ABangingDonk/OpenHaldexDue/media/v0.1_board.jpg

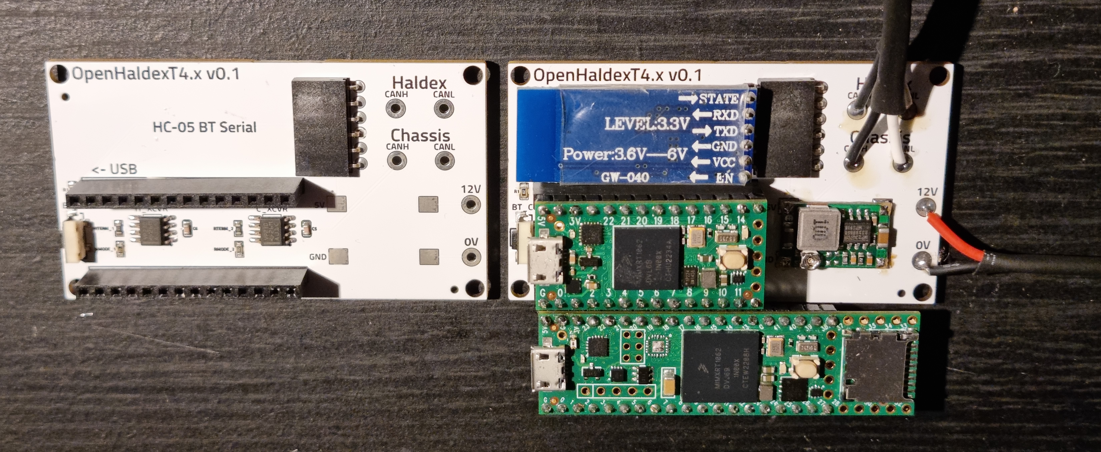
media/v0.1_board.jpg
