ABangingDonk/OpenHaldexDue/Interceptor/openhaldex_interceptor/openhaldex_interceptor.ino

/*
 * MIT License
 * 
 * Copyright (c) 2018 ABangingDonk
 * 
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
 * OpenHaldex interceptor:
 *  Forwards all CAN frames (except those from the master) to the haldex
 *  Master frames are read into persistent_config.mode and false_slip globals
 *
 * Some experimentation to be done with regards to false_slip and BRAKES1
 * frames... I've seen a maximum haldex engagement of 0xc6, I'm sure there's
 * more to be had here.
 *
 * At the very least, we can keep the haldex enaged through braking by editing
 * the brake pedal signal sent in BRAKES1.
 */

#include "variant.h"
#include <due_can.h>
#include <Timer.h>
#include "DueFlashStorage.h"
#include <stdio.h>

#define ARRAY_LEN(array)    ((size_t)(sizeof(array) / sizeof(array[0])))

//Leave defined if you use native port, comment if using programming port
//#define Serial SerialUSB

#define HALDEX_ID                 0x2C0
#define BRAKES1_ID                0x1A0
#define BRAKES3_ID                0x4A0
#define MOTOR1_ID                 0x280
#define MOTOR2_ID                 0x288
#define MOTOR3_ID                 0x380
#define MOTOR6_ID                 0x488
#define INTERCEPTOR_INFO_ID       0x7fb
#define INTERCEPTOR_DATA_CTRL_ID  0x7fc
#define MASTER_MODE_ID            0x7fd
#define MASTER_DATA_CTRL_ID       0x7fe
#define MASTER_DATA_ID            0x7ff

#define MODE_STOCK   0x0
#define MODE_FWD     0x1
#define MODE_5050    0x2
#define MODE_CUSTOM  0x3

#define DATA_CTRL_CHECK_LOCKPOINTS  0
#define DATA_CTRL_CLEAR             1
#define DATA_CTRL_CHECK_MODE        2

#define CAN0_DEBUG      0
#define CAN1_DEBUG      0
#define STATE_DEBUG     0

#define NUM_LOCK_POINTS 10

typedef struct lockpoint{
    uint8_t speed;
    uint8_t lock;
    uint8_t intensity;
}lockpoint;

typedef struct PersistentConfig{
    uint8_t mode;
    float ped_threshold;
    lockpoint lockpoints[NUM_LOCK_POINTS];
}PersistentConfig;

static PersistentConfig persistent_config;
DueFlashStorage dueFlashStorage;
static uint16_t lockpoint_rx = 0;
static uint8_t lockpoint_count = 0;
Timer t;
static uint8_t vehicle_speed = 0;
static float lock_target = 0;
static float ped_value = 0;

#if STATE_DEBUG
static char s[128];
#endif

static float get_lock_target_adjustment(void)
{
    float target = 0;
    
    /* Find out which lockpoints we're between in terms of speed..
     * Look for the lockpoint above our current speed (lp_upper) */
    lockpoint lp_lower = persistent_config.lockpoints[0];
    lockpoint lp_upper = persistent_config.lockpoints[lockpoint_count - 1];

    for (int i = 0; i < lockpoint_count; i++)
    {
        if (vehicle_speed <= persistent_config.lockpoints[i].speed)
        {
            lp_upper = persistent_config.lockpoints[i];
            lp_lower = persistent_config.lockpoints[(i == 0) ? 0 : i - 1];
            break;
        }
    }
    
    /* Get the easy cases out the way first... */
    if (vehicle_speed <= lp_lower.speed)
    {
        return lp_lower.lock;
    }
    if (vehicle_speed >= lp_upper.speed)
    {
        return lp_upper.lock;
    }
        
    /* If locking at all... */
    if (ped_value > persistent_config.ped_threshold || persistent_config.ped_threshold == 0)
    {
        /* Need to interpolate */
        float inter = (float)(lp_upper.speed - lp_lower.speed) / (float)(vehicle_speed - lp_lower.speed);

        target = lp_lower.lock + ((float)(lp_upper.lock - lp_lower.lock) / inter);
        #if STATE_DEBUG
        sprintf(s, "lp_upper:%d@%d lp_lower:%d@%d speed:%d target=%0.2f", 
                lp_upper.lock, lp_upper.speed, lp_lower.lock, lp_lower.speed, vehicle_speed, target);
        Serial.println(s);
        #endif
    }
    /* Else leave target at its initial value of 0. */

    return target;
}

static uint8_t get_lock_target_adjusted_value(uint8_t value)
{    
    if (persistent_config.mode == MODE_5050)
    {
        if (ped_value > persistent_config.ped_threshold || persistent_config.ped_threshold == 0)
        {
            return value;
        }
        
        return 0;
    }
    else
    {
        float target = get_lock_target_adjustment();
        lock_target = target;
        
        /*
         * Hackery to get the response closer to the target... we are trying to control the
         * Haldex as if it's linear.. but it's not. In future, I'd like to implement some sort
         * of feedback loop to trim the calculation being made here but this will do for now.
         */
        target = (target / 2) + 20;
        
        return value * (target / 100);
    }
}

static void get_lock_data(CAN_FRAME *frame)
{   
    uint8_t adjusted_slip;
    switch(frame->id)
    {
        case MOTOR1_ID:
            frame->data.bytes[0] = 0;
            frame->data.bytes[1] = get_lock_target_adjusted_value(0xf0);
            frame->data.bytes[2] = 0x20;
            frame->data.bytes[3] = get_lock_target_adjusted_value(0x4e);
            frame->data.bytes[4] = get_lock_target_adjusted_value(0xf0);
            frame->data.bytes[5] = get_lock_target_adjusted_value(0xf0);
            frame->data.bytes[6] = 0x20;
            frame->data.bytes[7] = get_lock_target_adjusted_value(0xf0);
            break;
        case MOTOR3_ID:
            frame->data.bytes[2] = get_lock_target_adjusted_value(0xfa);
            frame->data.bytes[7] = get_lock_target_adjusted_value(0xfe);
            break;
        case MOTOR6_ID:
            frame->data.bytes[1] = get_lock_target_adjusted_value(0xfe);
            frame->data.bytes[2] = get_lock_target_adjusted_value(0xfe);
            break;
        case BRAKES3_ID:
            adjusted_slip = get_lock_target_adjusted_value(0xff);
            frame->data.high = (0xa << 24) + (0xa << 8);
            frame->data.low = frame->data.high + (adjusted_slip << 16) + adjusted_slip;
            break;
        case BRAKES1_ID:
            //frame->data.bytes[1] &= ~0x8;
            frame->data.bytes[2] = 0x0;
            frame->data.bytes[3] = 0xa;
            break;
    }
}

void update_eeprom(void* context)
{
    byte *old_data = dueFlashStorage.readAddress(4);
    // If config has changed then we should update it
    if (memcmp(old_data, &persistent_config, sizeof(persistent_config)))
    {
        byte new_data[sizeof(persistent_config)];
        memcpy(new_data, &persistent_config, sizeof(persistent_config));
        dueFlashStorage.write(4, new_data, sizeof(new_data));
    }
}

void haldex_callback(CAN_FRAME *incoming)
{
    Can1.sendFrame(*incoming, 7);

    #if CAN0_DEBUG
    if(incoming->data.bytes[0])
    {
        Serial.print("ID: 0x");
        Serial.print(incoming->id,HEX);
        Serial.print(" DATA: ");
        for(int i = 0; i < incoming->length; i++)
        {
            Serial.print(incoming->data.bytes[i],HEX);
            Serial.print(" ");
        }
        Serial.println();
    }
    #endif
}

static void send_interceptor_info(void)
{
    CAN_FRAME rsp;
    rsp.id = INTERCEPTOR_INFO_ID;
    rsp.extended = false;
    rsp.data.bytes[0] = lock_target;
    rsp.data.bytes[1] = vehicle_speed;
    rsp.length = 2;
    Can1.sendFrame(rsp, 7);
}

void can1_rx_callback(CAN_FRAME *incoming)
{
    uint32_t id = incoming->id;
    
    if(id == MASTER_MODE_ID)
    {
        // We'll get this periodically from the master to tell us which mode we should be in.
        persistent_config.mode = incoming->data.bytes[0];
        persistent_config.ped_threshold = incoming->data.bytes[1];

        if (incoming->data.bytes[0] == MODE_5050)
        {
            if (ped_value > persistent_config.ped_threshold || persistent_config.ped_threshold == 0)
            {
                lock_target = 100;
            }
            else
            {
                lock_target = 0;
            }
        }
        else if (incoming->data.bytes[0] == MODE_FWD)
        {
            lock_target = 0;
        }
        
        send_interceptor_info();
    }
    else if (id == MASTER_DATA_ID)
    {
        // Receiving data for custom lock mode
        uint8_t lockpoint_index = incoming->data.bytes[0];
        
        // Make sure that the index we were given is within range
        if (lockpoint_index < NUM_LOCK_POINTS)
        {
            // Read lockpoint properties out of the CAN packet
            persistent_config.lockpoints[lockpoint_index].speed = incoming->data.bytes[1];
            persistent_config.lockpoints[lockpoint_index].lock = incoming->data.bytes[2];
            persistent_config.lockpoints[lockpoint_index].intensity = incoming->data.bytes[3];
            
            // Set the bit for this lockpoint to indicate we've received it
            lockpoint_rx |= (1 << lockpoint_index);
            
            // Stash the number of lockpoints to avoid having to calculate it later
            lockpoint_count++;
        }
    }
    else if (id == MASTER_DATA_CTRL_ID)
    {
        // Transfer control for custom lock mode data
        CAN_FRAME rsp;
        rsp.id = INTERCEPTOR_DATA_CTRL_ID;
        rsp.extended = false;
        switch (incoming->data.bytes[0])
        {
            case DATA_CTRL_CHECK_LOCKPOINTS:
            {
                // Send the bitfield value to say which lockpoints we've received
                rsp.data.bytes[0] = DATA_CTRL_CHECK_LOCKPOINTS;
                rsp.data.bytes[1] = lockpoint_rx & 0xff;
                rsp.data.bytes[2] = (lockpoint_rx << 8) & 0xff;
                rsp.length = 3;
                Can1.sendFrame(rsp, 7);
                #if CAN1_DEBUG
                    if(1)//incoming->id == MOTOR1_ID)
                    {
                        Serial.print("TX: ID: 0x");
                        Serial.print(rsp.id,HEX);
                        Serial.print(" DATA[");
                        Serial.print(rsp.length);
                        Serial.print("] : ");
                        for(int i = 0; i < rsp.length; i++)
                        {
                            Serial.print(rsp.data.bytes[i],HEX);
                            Serial.print(" ");
                        }
                        Serial.println();
                    }
                #endif
                break;
            }
            case DATA_CTRL_CLEAR:
            {
                // We've been told to clear - so clear the lockpoints and bitfield
                lockpoint_rx = 0;
                lockpoint_count = 0;
                memset(persistent_config.lockpoints, 0, sizeof(persistent_config.lockpoints));
                break;
            }
            case DATA_CTRL_CHECK_MODE:
            {
                // Send the bitfield value to say which lockpoints we've received
                rsp.data.bytes[0] = DATA_CTRL_CHECK_MODE;
                rsp.data.bytes[1] = persistent_config.mode;
                rsp.data.bytes[2] = persistent_config.ped_threshold;
                
                rsp.length = 3;
                Can1.sendFrame(rsp, 7);
                #if CAN1_DEBUG
                    if(1)//incoming->id == MOTOR1_ID)
                    {
                        Serial.print("TX: ID: 0x");
                        Serial.print(rsp.id,HEX);
                        Serial.print(" DATA[");
                        Serial.print(rsp.length);
                        Serial.print("] : ");
                        for(int i = 0; i < rsp.length; i++)
                        {
                            Serial.print(rsp.data.bytes[i],HEX);
                            Serial.print(" ");
                        }
                        Serial.println();
                    }
                #endif
                break;
            }
            default:
            {
                // Error handling?
                break;
            }
        }
    }
    else
    {
        // Anything which has come from the car.. i.e. everything except Haldex and Master.
        switch(incoming->id)
        {
            case MOTOR1_ID:
                ped_value = incoming->data.bytes[5] * 0.4;
                
                if (persistent_config.mode == MODE_FWD)
                {
                    memset(&incoming->data, 0, incoming->length);
                }
                break;
            case MOTOR2_ID:
                vehicle_speed = (uint8_t)((incoming->data.bytes[3] * 100 * 128) / 10000);
                break;
        }

        if(persistent_config.mode == MODE_5050 || persistent_config.mode == MODE_CUSTOM)
        {
            get_lock_data(incoming);
        }

        Can0.sendFrame(*incoming);
    }
#if CAN1_DEBUG
    if(1)//incoming->id == MOTOR1_ID)
    {
        Serial.print("ID: 0x");
        Serial.print(incoming->id,HEX);
        Serial.print(" DATA: ");
        for(int i = 0; i < incoming->length; i++)
        {
            Serial.print(incoming->data.bytes[i],HEX);
            Serial.print(" ");
        }
        Serial.println();
    }
    CAN_FRAME rsp;
    rsp.id = HALDEX_ID;
    rsp.extended = false;
    rsp.length = 2;
    rsp.data.bytes[0] = 0x0;
    rsp.data.bytes[1] = 0x85;
    haldex_callback(&rsp);
#endif
}

void setup()
{    
    Serial.begin(115200);

    Can0.begin(CAN_BPS_500K);
    Can1.begin(CAN_BPS_500K);
    
    Can0.setRXFilter(0, HALDEX_ID, 0x7ff, false);
    Can0.setCallback(0, haldex_callback);
    Can0.mailbox_set_mode(1,3);
    Can0.mailbox_set_mode(2,3);
    Can0.mailbox_set_mode(3,3);
    Can0.mailbox_set_mode(4,3);
    Can0.mailbox_set_mode(5,3);
    Can0.mailbox_set_mode(6,3);
    Can0.mailbox_set_mode(7,3);
    
    Can1.setRXFilter(0, 0, 0, false);
    Can1.setCallback(0, can1_rx_callback);
    Can1.setRXFilter(1, 0, 0, false);
    Can1.setCallback(1, can1_rx_callback);
    Can1.setRXFilter(2, 0, 0, false);
    Can1.setCallback(2, can1_rx_callback);
    Can1.setRXFilter(3, 0, 0, false);
    Can1.setCallback(3, can1_rx_callback);
    Can1.setRXFilter(4, 0, 0, false);
    Can1.setCallback(4, can1_rx_callback);
    Can1.setRXFilter(5, 0, 0, false);
    Can1.setCallback(5, can1_rx_callback);
    Can1.setRXFilter(6, 0, 0, false);
    Can1.setCallback(6, can1_rx_callback);
    Can1.mailbox_set_mode(7,3);
    
    Can0.disable_tx_repeat();
    Can1.disable_tx_repeat();
    
    if (dueFlashStorage.read(0) != 0xff)
    {
        // We have saved config - so load it...
        byte *b = dueFlashStorage.readAddress(4);
        memcpy(&persistent_config, b, sizeof(persistent_config));
    }
    else
    {
        // We didn't have a saved config.. so write 0 to address 0 so that we
        // don't come through this again.
        dueFlashStorage.write(0, 0x00);
        
        memset(&persistent_config, 0, sizeof(persistent_config));
        
        // And put a blank copy of config so that we are less likely to load
        // f's and get into some weird state....
        update_eeprom((void*)0);
    }
    
    // Update EEPROM every 2 seconds (will only write if contents needs updating)
    t.every(2000, update_eeprom, (void*)0);
}

void loop()
{
    /*
     * Do nothing, we're purely interrupt driven.
     */
     
    t.update(); // Update the timer
}
