ABangingDonk/OpenHaldexDue/(commit log)

2018-11-25 Initial commit
    It builds but it's broken.. I'm just getting my work into source control.
    [openhaldex_interceptor.ino, openhaldex_master.ino]
2018-12-02 Release 1.0
    Better error handling in the App, minor tweaks to the interceptor & master code
    [openhaldex_interceptor.ino, openhaldex_master.ino]
2019-11-06 Custom modes added to App
    Done a lot of the groundwork for supporting custom modes in the App...
    THIS WILL LEAVE THE SYSTEM IN STOCK MODE.. DO NOT USE!
2020-04-19 Finalise mode switching
    Added mode switching to Master and Interceptor, fixed the obvious bugs in the App resulting from this.
    Still needs tidying up and testing in the car but this looks very promising at the moment.
    [openhaldex_interceptor.ino, openhaldex_master.ino, openhaldex_master_master.ino]
2020-04-21 Lockpoint interpolation and min. pedal
    Implemented interpolation between two lockpoints and added speed and target lock readouts to the App.
    Also added a minimum pedal position in order for 50/50 and custom modes to work - settable between 0 and 100%. This is to prevent wheels skipping when parking or performing slow operations - 5 to 10% will do the job just fine I think.
    Still untested.....
    [openhaldex_interceptor.ino, openhaldex_master.ino]
2020-04-24 All of the fixes
    Finally, most of the bugs are gone and everything is pretty much good to go.
    Can't seem to set a mode with more than 8 lockpoints.. but I'll deal with that later
    [openhaldex_interceptor.ino]
